kingyoPiyo/Tang-Nano_100BASE-FX_Talker/doc/Ethernet_Frame.png

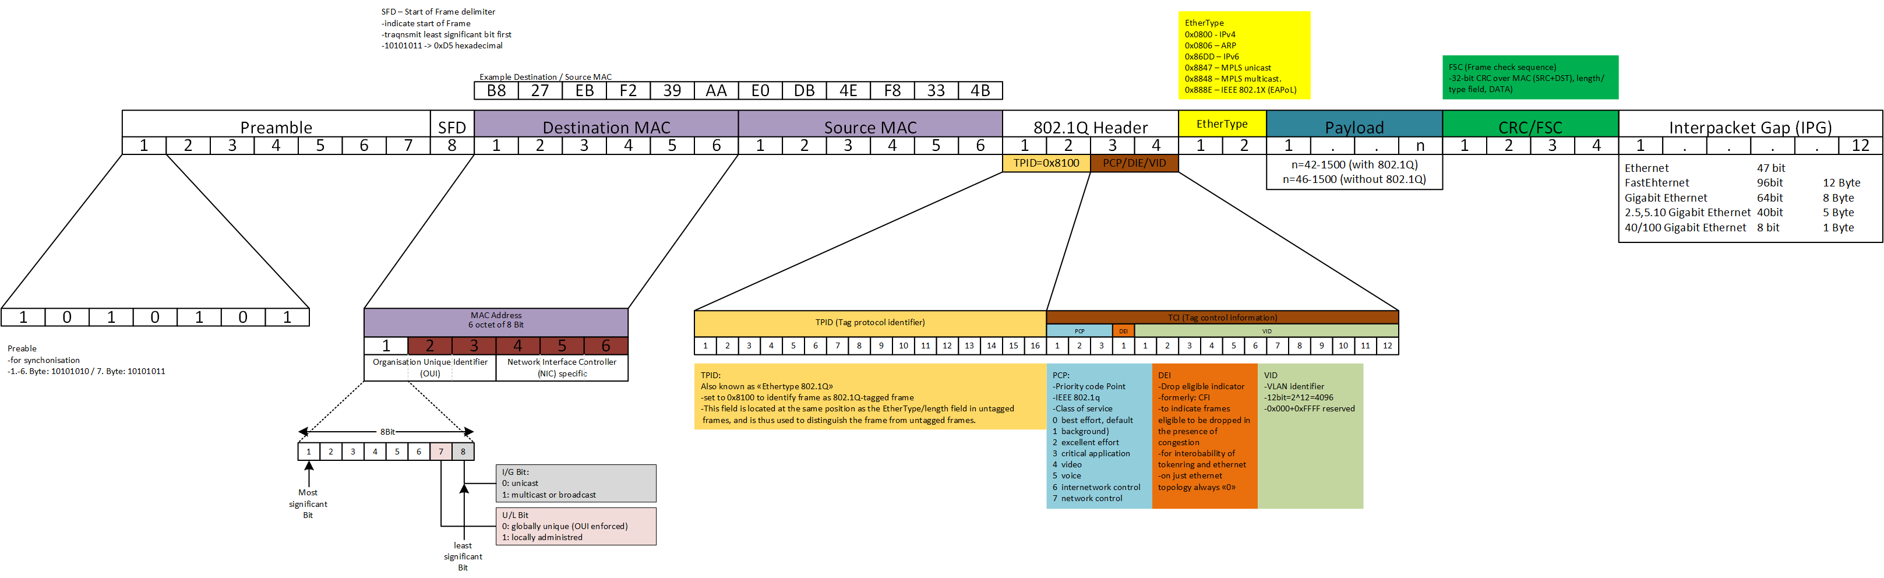
doc/Ethernet_Frame.png
