kingyoPiyo/Tang-Nano_100BASE-FX_Talker/(threads)

Thread 1 (2021-12-11):

use of pin 33

B-Laurent, 2021-12-11:
Hello,

One question about the adc part of circuit.

There is no declaration about the pin 33 it in the file sfp_tx.cst.
Could you enlighten me about it ?

Thank for help

kingyoPiyo, 2021-12-12:
Hello.

Pin 34 and pin 33 are a differential pair of LVDS.
Pin 34 is a positive input and pin 33 is a negative input.

When pin 34 is set to LVDS25, pin 33 of the pair is automatically assigned.

B-Laurent, 2021-12-12:
Hello,
Thank you for these clarifications
Have a good day

LAurent_B

Closed 2021-12-12.
