kingyoPiyo/Tang-Nano_100BASE-FX_Talker/src/ip/gowin_pll/gowin_pll.v

//Copyright (C)2014-2019 Gowin Semiconductor Corporation.
//All rights reserved.
//File Title: IP file
//GOWIN Version: V1.9.2.02Beta
//Part Number: GW1N-LV1QN48C6/I5
//Created Time: Sun Sep 13 22:18:49 2020

module Gowin_PLL (clkout, lock, reset, clkin);

output clkout;
output lock;
input reset;
input clkin;

wire clkoutp_o;
wire clkoutd_o;
wire clkoutd3_o;
wire gw_gnd;

assign gw_gnd = 1'b0;

PLL pll_inst (
    .CLKOUT(clkout),
    .LOCK(lock),
    .CLKOUTP(clkoutp_o),
    .CLKOUTD(clkoutd_o),
    .CLKOUTD3(clkoutd3_o),
    .RESET(reset),
    .RESET_P(gw_gnd),
    .RESET_I(gw_gnd),
    .RESET_S(gw_gnd),
    .CLKIN(clkin),
    .CLKFB(gw_gnd),
    .FBDSEL({gw_gnd,gw_gnd,gw_gnd,gw_gnd,gw_gnd,gw_gnd}),
    .IDSEL({gw_gnd,gw_gnd,gw_gnd,gw_gnd,gw_gnd,gw_gnd}),
    .ODSEL({gw_gnd,gw_gnd,gw_gnd,gw_gnd,gw_gnd,gw_gnd}),
    .PSDA({gw_gnd,gw_gnd,gw_gnd,gw_gnd}),
    .DUTYDA({gw_gnd,gw_gnd,gw_gnd,gw_gnd}),
    .FDLY({gw_gnd,gw_gnd,gw_gnd,gw_gnd})
);

defparam pll_inst.FCLKIN = "50";
defparam pll_inst.DYN_IDIV_SEL = "false";
defparam pll_inst.IDIV_SEL = 1;
defparam pll_inst.DYN_FBDIV_SEL = "false";
defparam pll_inst.FBDIV_SEL = 4;
defparam pll_inst.DYN_ODIV_SEL = "false";
defparam pll_inst.ODIV_SEL = 4;
defparam pll_inst.PSDA_SEL = "0000";
defparam pll_inst.DYN_DA_EN = "false";
defparam pll_inst.DUTYDA_SEL = "1000";
defparam pll_inst.CLKOUT_FT_DIR = 1'b1;
defparam pll_inst.CLKOUTP_FT_DIR = 1'b1;
defparam pll_inst.CLKOUT_DLY_STEP = 0;
defparam pll_inst.CLKOUTP_DLY_STEP = 0;
defparam pll_inst.CLKFB_SEL = "internal";
defparam pll_inst.CLKOUT_BYPASS = "false";
defparam pll_inst.CLKOUTP_BYPASS = "false";
defparam pll_inst.CLKOUTD_BYPASS = "false";
defparam pll_inst.DYN_SDIV_SEL = 2;
defparam pll_inst.CLKOUTD_SRC = "CLKOUT";
defparam pll_inst.CLKOUTD3_SRC = "CLKOUT";
defparam pll_inst.DEVICE = "GW1N-1";

endmodule //Gowin_PLL
